CuculusBand/Light-Box/2_Release/Light-Box V1.00.00/Light-Box-B002/Light-Box-B002_PCB_V1.00.00.pdf

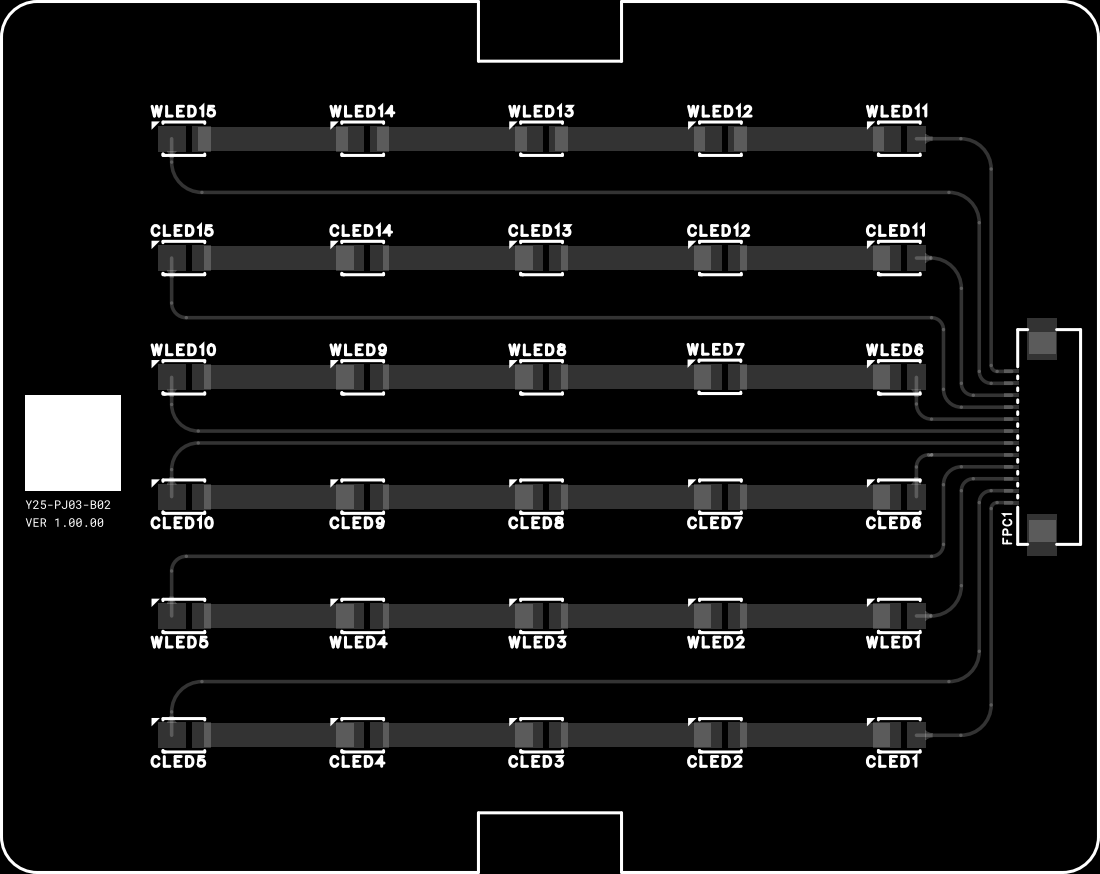
[picture p1: page 1]
