CuculusBand/Light-Box/1_Design_Documents/Appearance Sketch.png

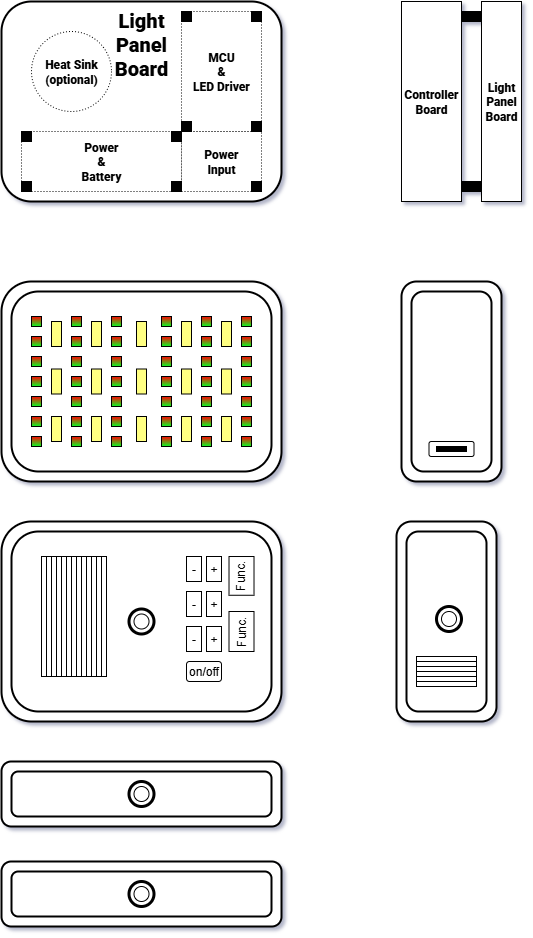
1_Design_Documents/Appearance Sketch.png
