CuculusBand/Light-Box/1_Design_Documents/Hardware Block Diagram.png

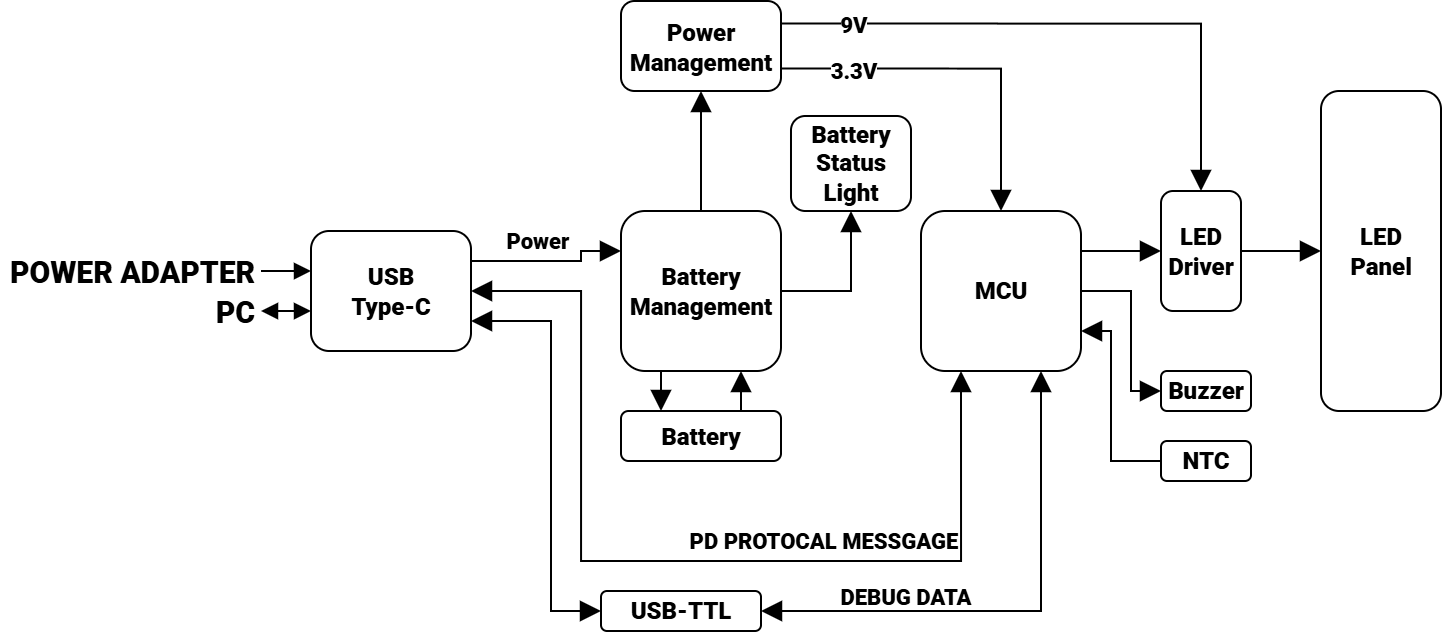
1_Design_Documents/Hardware Block Diagram.png
