CuculusBand/Light-Box/2_Release/Light-Box V1.00.00/Light-Box-B001/Light-Box-B001_BOM_V1.00.00.xlsx

Sheet: BOM
Bill of Materials | BOM_Light Box Main Board_Main Board_2025-09-27
Project Title： | Light Box
Variant:
Report Time： | 2025.9.27 13:52:49
No. | Quantity | Comment | Designator | Footprint | Value | Manufacturer Part | Manufacturer | Supplier Part | Supplier
1 | 3 | NCD0805G1 | BATLED1, BATLED2, LED2 | LED0805-R-RD |  | NCD0805G1 | 国星光电 | C84260 | LCSC
2 | 3 | NCD0805O1 | BATLED3, BATLED4, LED1 | LED0805-RD_ORANGE |  | NCD0805O1 | 国星光电 | C84262 | LCSC
3 | 1 | 2.4kHz | BUZZER1 | BUZ-TH_BD12.0-P7.60-D0.6-FD | 2.4kHz | TMB12A05 | 华能 | C96093 | LCSC
4 | 11 | 100nF | C1, C7, C12, C47, C48, C49, C50, C52, C53, C55, C56 | C0603 | 100nF | TCC0603X7R104K500CT | CCTC(三环) | C282519 | LCSC
5 | 1 | 10uF | C6 | C0603 | 10uF | CL10A106KP8NNNC | SAMSUNG(三星) | C19702 | LCSC
6 | 1 | 10uF | C16 | CAP-TH_BD4.0-P1.50-D0.8-FD | 10uF | KS106M050C07RR0VH2FP0 | CX(承兴) | C32856 | LCSC
7 | 1 | 22uF | C17 | CAP-TH_BD5.0-P2.00-D0.5-FD | 22uF | ERG50V22M5X11 | 捷而瑞 | C47344185 | LCSC
8 | 1 | 100nF | C18 | C1206 | 100nF | TCC1206M3L104J500FT | CCTC(三环) | C359189 | LCSC
9 | 4 | 4.7uF | C25, C26, C31, C32 | C0805 | 4.7uF | CGA0805X7R475K350MT | HRE(芯声) | C6119943 | LCSC
10 | 4 | 10uF | C27, C28, C29, C30 | C1206 | 10uF | CL31A106KBHNNNE | SAMSUNG(三星) | C13585 | LCSC
11 | 2 | 10uF | C37, C42 | C0805 | 10uF | 0805X106M250NT | FH(风华) | C669099 | LCSC
12 | 8 | 22uF | C38, C39, C40, C41, C43, C44, C45, C46 | C0805 | 22uF | CGA0805X5R226M250MT | HRE(芯声) | C6119899 | LCSC
13 | 3 | 1uF | C51, C54, C57 | C0603 | 1uF | CL10A105KB8NNNC | SAMSUNG(三星) | C15849 | LCSC
14 | 1 | B2B-XH-A(LF)(SN) | CN1 | CONN-TH_B2B-XH-A-LF-SN |  | B2B-XH-A(LF)(SN) | JST | C158012 | LCSC
15 | 2 | SS34 | D2, D3 | SMA_L4.3-W2.6-LS5.0-FD |  | SS34 | 宏迦橙 | C7420365 | LCSC
16 | 1 | SMAJ5.0A | D5 | SMA_L4.4-W2.6-LS5.0-RD |  | SMAJ5.0A | MDD(辰达半导体) | C113952 | LCSC
17 | 2 | PESD5V0L1BA | D6, D7 | SOD-323_L1.7-W1.3-LS2.5-BI |  | PESD5V0L1BA | TECH PUBLIC(台舟) | C2827691 | LCSC
18 | 1 | DS38W | D8 | SOD-123FL_L2.7-W1.8-LS3.8-RD |  | DS38W | 晶导微电子 | C437960 | LCSC
19 | 2 | LGS63032 | DRIVER1, DRIVER2 | SOT-23-6_L2.9-W1.6-P0.95-LS2.8-BR |  | LGS63032 | Legend-Si(棱晶半导体) | C5123977 | LCSC
20 | 1 | USBLC6-2SC6 | ESD1 | SOT-23-6_L2.9-W1.6-P0.95-LS2.8-BL |  | USBLC6-2SC6 | UMW(友台半导体) | C2687116 | LCSC
21 | 1 | AFA01-S12FCA-00 | FPC1 | FPC-SMD_12P-P1.00_FGS-XJ-H2.0 |  | AFA01-S12FCA-00 | JS(钜硕电子) | C262757 | LCSC
22 | 1 | GZ2012D601TF | L1 | L0805 |  | GZ2012D601TF | Sunlord(顺络) | C1017 | LCSC
23 | 2 | 22uH | L2, L3 | IND-SMD_L11.5-W10.0_FXL1040 | 22uH | FXL1040-220-M | cjiang(长江微电) | C475917 | LCSC
24 | 1 | 1uH | L5 | IND-SMD_L5.4-W5.2_FXL0530 | 1uH | FXL0530-1R0-M | cjiang(长江微电) | C475517 | LCSC
25 | 1 | 4.7uH | L6 | IND-SMD_L4.4-W4.2 | 4.7uH | FXL0420-4R7-M | cjiang(长江微电) | C167208 | LCSC
26 | 1 | 2N7002 | Q2 | SOT-23-3_L2.9-W1.3-P1.90-LS2.4-BR |  | 2N7002 | 宏迦橙 | C7420321 | LCSC
27 | 1 | S9013-E | Q3 | SOT-23-3_L2.9-W1.3-P1.90-LS2.4-BR |  | S9013-E | MDD(辰达半导体) | C41371419 | LCSC
28 | 2 | NC | R1, R2 | R0805 | NC
29 | 2 | MF52D 103F3950-100 | R3, R4 | RES-TH_BD3.0-P2.00-D0.3 |  | MF52D 103F3950-100 | 时恒 | C394024 | LCSC
30 | 2 | 4.7kΩ | R5, R8 | R0603 | 4.7kΩ | FRC0603F4701TS | FOJAN(富捷) | C2907034 | LCSC
31 | 2 | 510Ω | R6, R7 | R0805 | 510Ω | AECR0805F510RK9 | RESI(开步睿思) | C328402 | LCSC
32 | 11 | 10kΩ | R19, R21, R22, R24, R42, R47, R48, R49, R50, R51, R54 | R0805 | 10kΩ | 0805W8F1002T5E | UNI-ROYAL(厚声) | C17414 | LCSC
33 | 2 | 200kΩ | R20, R23 | R0805 | 200kΩ | FRC0805F2003TS | FOJAN(富捷) | C2907238 | LCSC
34 | 1 | 2Ω | R40 | R1206 | 2Ω | RC1206FR-072RL | YAGEO(国巨) | C137316 | LCSC
35 | 1 | 500mΩ | R41 | R0603 | 500mΩ | SCR0603JR500 | VO(翔胜) | C3017643 | LCSC
36 | 1 | 27kΩ | R43 | R0603 | 27kΩ | FRC0603F2702TS | FOJAN(富捷) | C2930084 | LCSC
37 | 1 | 1.8kΩ | R44 | R0603 | 1.8kΩ | 0603WAF1801T5E | UNI-ROYAL(厚声) | C4177 | LCSC
38 | 1 | 10kΩ | R45 | R0603 | 10kΩ | 0603WAF1002T5E | UNI-ROYAL(厚声) | C25804 | LCSC
39 | 1 | 1kΩ | R46 | R0805 | 1kΩ | ARG05BTC1001 | Viking(光颉) | C309081 | LCSC
40 | 1 | 100kΩ | R52 | R0603 | 100kΩ | 0603WAF1003T5E | UNI-ROYAL(厚声) | C25803 | LCSC
41 | 1 | 10Ω | R53 | R0603 | 10Ω | 0603WAF100JT5E | UNI-ROYAL(厚声) | C22859 | LCSC
42 | 1 | 51kΩ | R55 | R0805 | 51kΩ | 0805W8F5102T5E | UNI-ROYAL(厚声) | C17737 | LCSC
43 | 1 | 0Ω | R56 | R1206 | 0Ω | 1206W4F0000T5E | UNI-ROYAL(厚声) | C17888 | LCSC
44 | 2 | 1.1R | RSENSE1, RSENSE2 | R1210 | 1.1R | FRC1210F1R10TS | FOJAN(富捷) | C2933808 | LCSC
45 | 1 | EC11E15244G1 | SW1 | SW-TH_EC11E15244G1 |  | EC11E15244G1 | ALPSALPINE(阿尔卑斯阿尔派) | C370970 | LCSC
46 | 1 | PZ254V-11-04P | SWD1 | HDR-TH_4P-P2.54-V-M |  | PZ254V-11-04P | XFCN(兴飞) | C2691448 | LCSC
47 | 1 | K2-1107ST-A4DW-06 | SWRST | KEY-SMD_L6.2-W3.6-LS8.0 |  | K2-1107ST-A4DW-06 | 韩国韩荣 | C118141 | LCSC
48 | 2 | ZX-QC-ZC661626 | SW_Mode, SW_PWOWER | SW-TH_4P-L6.0-W6.0-P4.50-LS6.3 |  | ZX-QC-ZC661626 | Megastar(兆星) | C7419934 | LCSC
49 | 1 | STM32G071KBT6 | U1 | LQFP-32_L7.0-W7.0-P0.80-LS9.0-BL |  | STM32G071KBT6 | ST(意法半导体) | C529348 | LCSC
50 | 1 | AMS1117-3.3 | U3 | SOT-223-4_L6.5-W3.5-P2.30-LS7.0-BR |  | AMS1117-3.3 | UMW(友台半导体) | C347222 | LCSC
51 | 1 | IP5306 | U4 | ESOP-8_L4.9-W3.9-P1.27-LS6.0-BL-EP |  | IP5306 | INJOINIC(英集芯) | C181692 | LCSC
52 | 1 | CH340X | U6 | MSOP-10_L3.0-W3.0-P0.50-LS5.0-BL |  | CH340X | WCH(南京沁恒) | C3035748 | LCSC
53 | 1 | MFP6291LR-G1 | U8 | SOT-23-6_L2.9-W1.6-P0.95-LS2.8-BR |  | MFP6291LR-G1 | MSKSEMI(美森科) | C30197559 | LCSC
54 | 1 | TYPE-C 16P QTWT | USB1 | USB-TYPE-C-SMD_TYPE-C-16P-QTWT |  | TYPE-C 16P QTWT | SHOU HAN(首韩) | C5187472 | LCSC

Sheet: Field Summary
Project Title | Light Box
Borard Title | Light Box Main Board
Schematic Title
PCB Title | Main Board
Variant Name
Total Quantity | 109
Report Time | 13:52:49
Report Date | 2025.9.27
Report Date&Time | 2025.9.27 13:52:49
File Name | BOM_Light Box Main Board_Main Board_2025-09-27
Filter Option | Add into BOM:no;
