CuculusBand/Light-Box/2_Release/Light-Box V1.00.00/Light-Box-B002/Light-Box-B002_BOM_V1.00.00.xlsx

Sheet: BOM
Bill of Materials | BOM_Light Box CW LED Panel_CW Panel_2025-08-09
Project Title： | Light Box
Variant:
Report Time： | 2025.8.9 20:29:36
No. | Quantity | Comment | Designator | Footprint | Value | Manufacturer Part | Manufacturer | Supplier Part | Supplier
1 | 15 | HL-AM-2835H421W-S1-08-HR6 6500K | CLED1, CLED2, CLED3, CLED4, CLED5, CLED6, CLED7, CLED8, CLED9, CLED10, CLED11, CLED12, CLED13, CLED14, CLED15 | LED-SMD_L3.5-W2.8-FD-2835_WHITE |  | HL-AM-2835H421W-S1-08-HR6 6500K | HONGLITRONIC(鸿利光电) | C516135 | LCSC
2 | 1 | AFA01-S12FCA-00 | FPC1 | FPC-SMD_12P-P1.00_FGS-XJ-H2.0 |  | AFA01-S12FCA-00 | JS(钜硕电子) | C262757 | LCSC
3 | 15 | HL-AM-2835H421W-S1-08-HR6 3000K | WLED1, WLED2, WLED3, WLED4, WLED5, WLED6, WLED7, WLED8, WLED9, WLED10, WLED11, WLED12, WLED13, WLED14, WLED15 | LED-SMD_L3.5-W2.8-FD-2835_WHITE |  | HL-AM-2835H421W-S1-08-HR6 3000K | HONGLITRONIC(鸿利光电) | C516131 | LCSC

Sheet: Field Summary
Project Title | Light Box
Borard Title | Light Box CW LED Panel
Schematic Title
PCB Title | CW Panel
Variant Name
Total Quantity | 31
Report Time | 20:29:36
Report Date | 2025.8.9
Report Date&Time | 2025.8.9 20:29:36
File Name | BOM_Light Box CW LED Panel_CW Panel_2025-08-09
Filter Option | Add into BOM:no;
