CuculusBand/Light-Box/2_Release/Light-Box V1.00.00/Light-Box-B001/Light-Box-B001_SCH_V1.00.00.pdf

STM32G0 | POWER/RST/OSC

# Power Supply

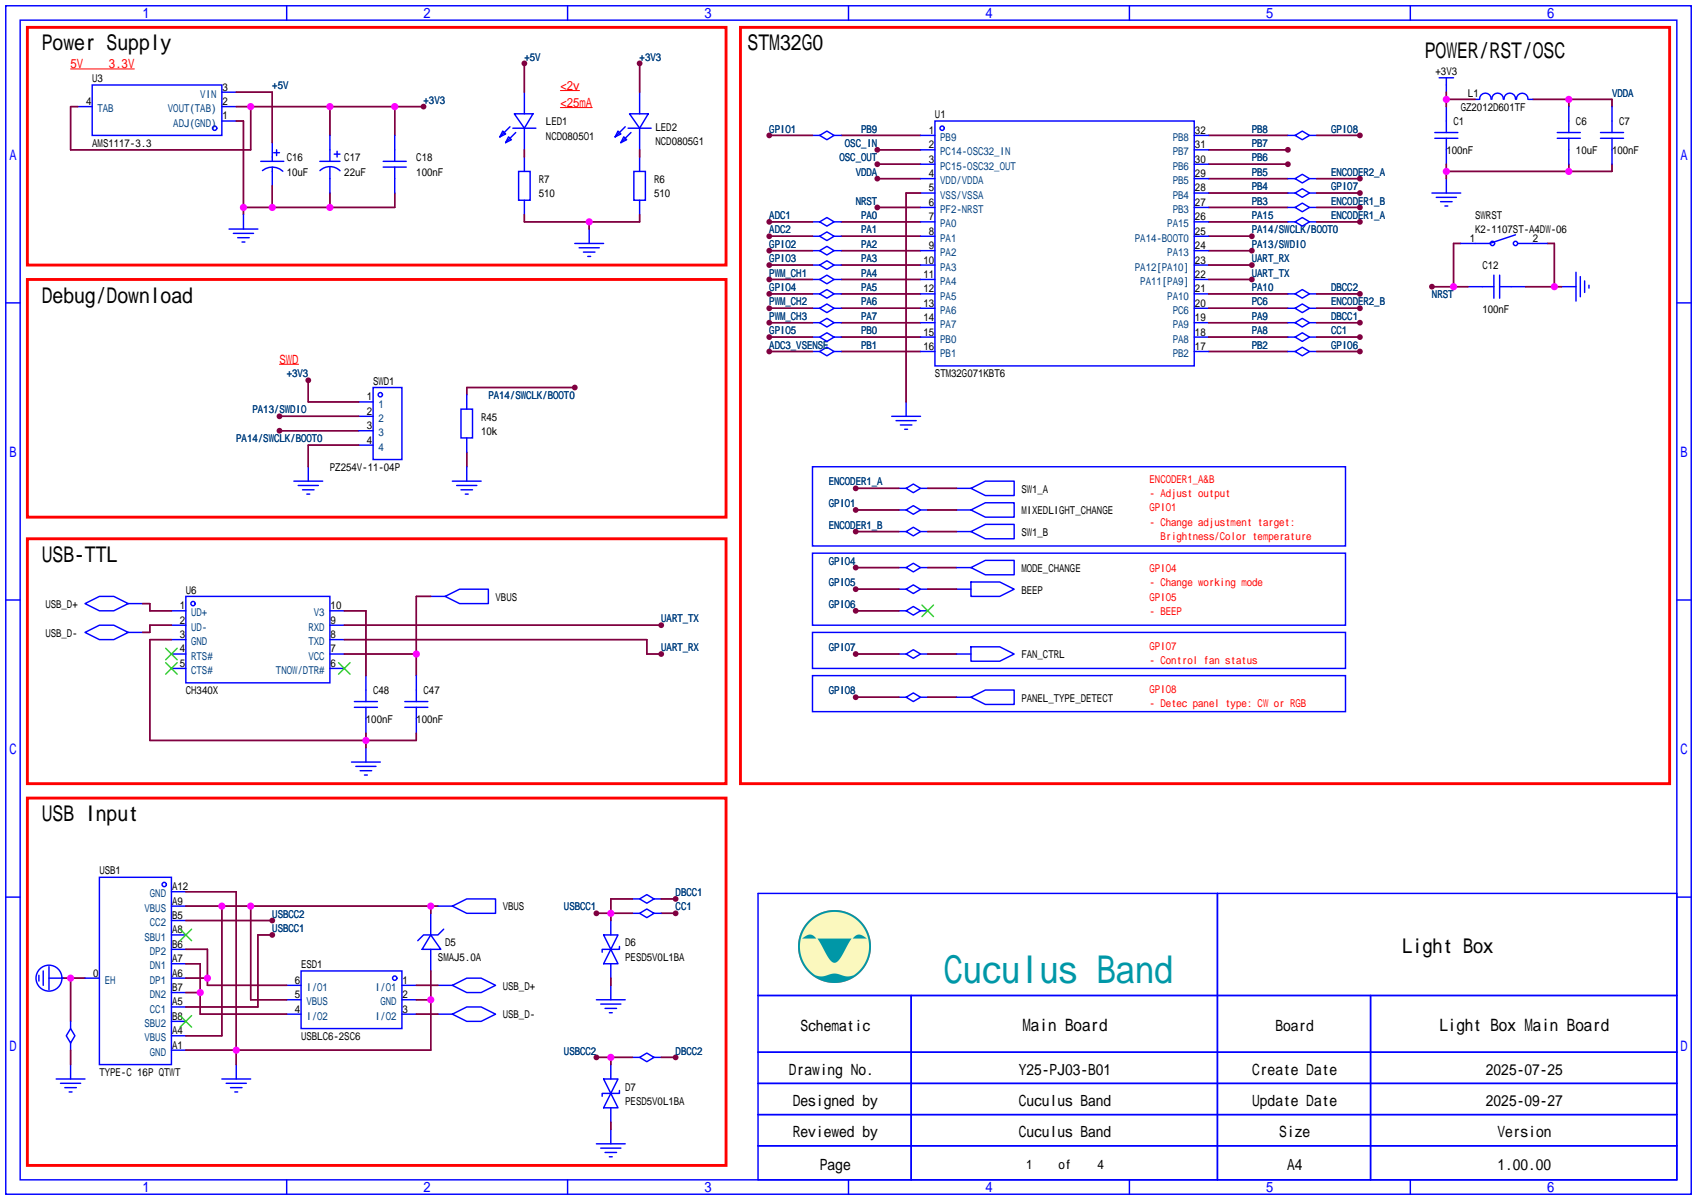
[picture p4: page 1]

GPIO8
- Detec panel type: CW or RGB

Cuculus Band | Light Box

Schematic | Main Board | Board | Light Box Main Board

Drawing No. | Y25-PJ03-B01 | Create Date | 2025-07-25

Designed by | Cuculus Band | Update Date | 2025-09-27

Reviewed by | Cuculus Band | Size | Version

Page | 1 of 4 | A4 | 1.00.00

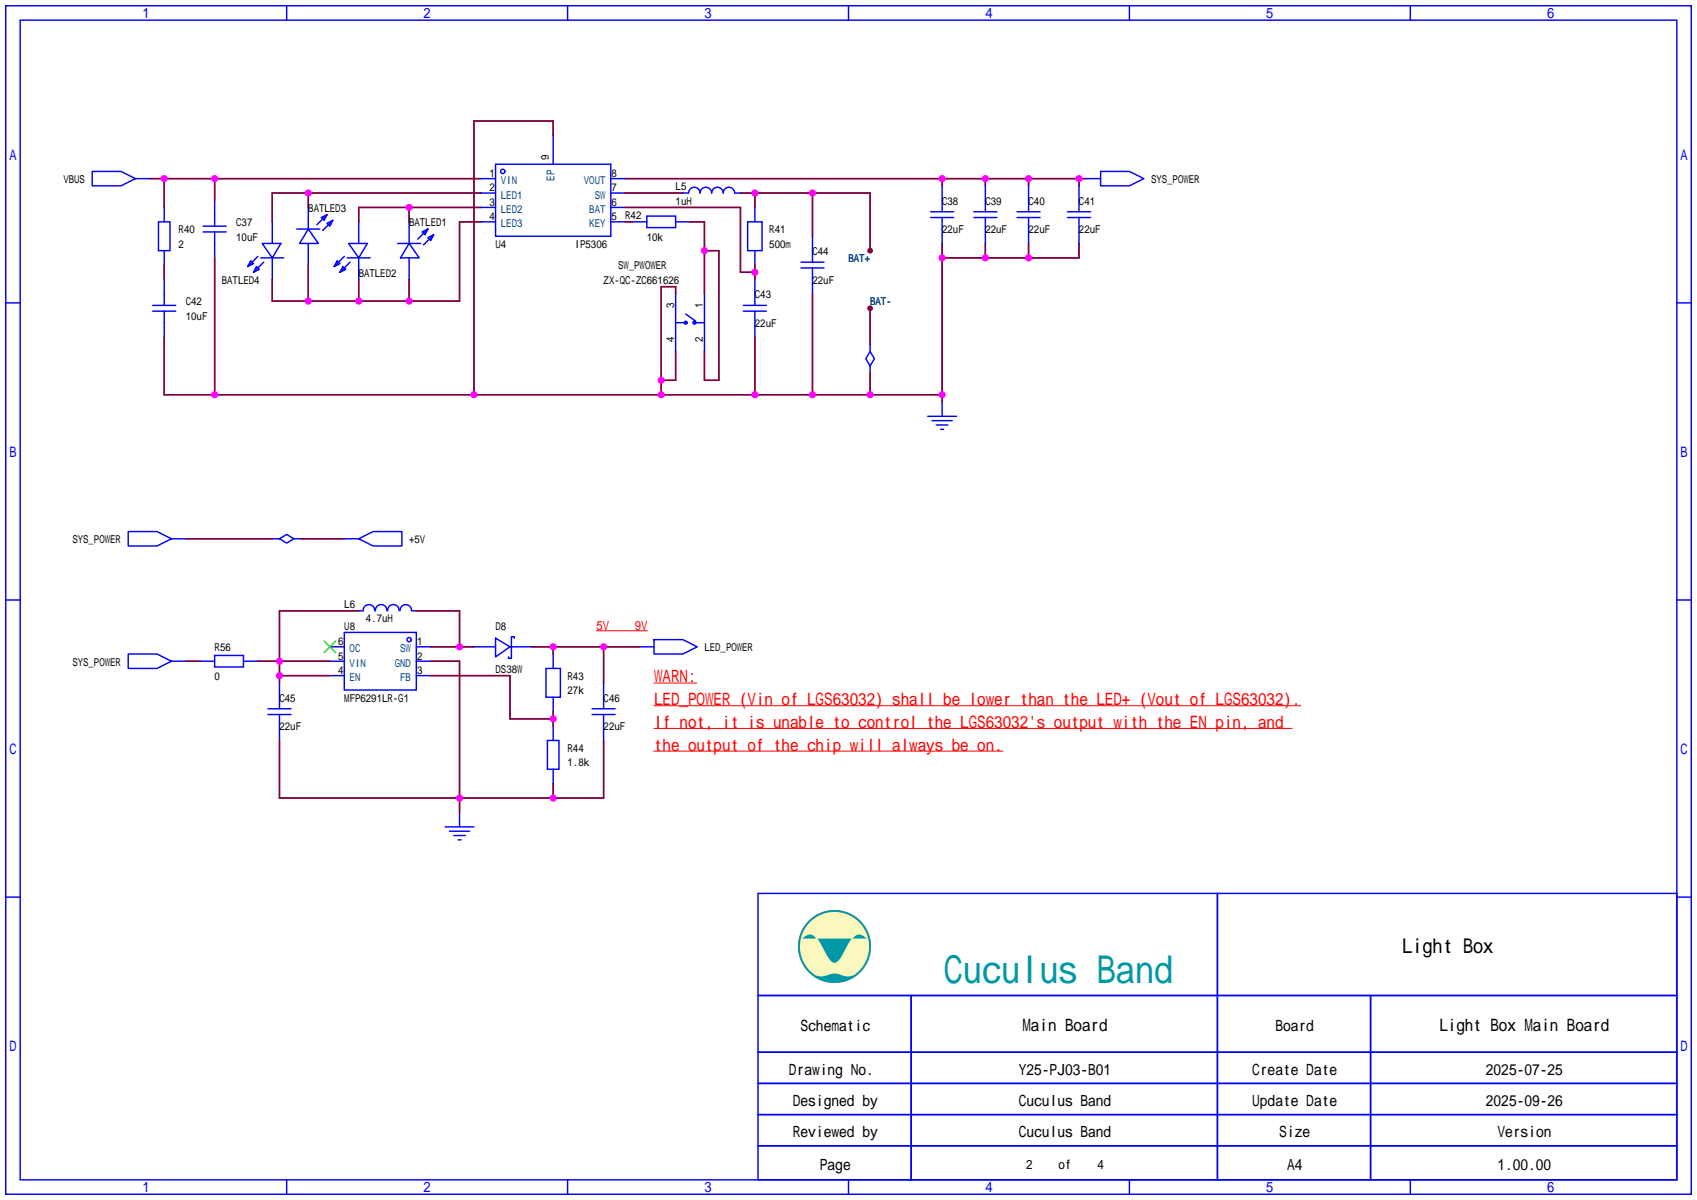
[picture p5: page 2]

LED_POWER (Vin of LGS63032) shall be lower than the LED+ (Vout of LGS63032).
If not, it is unable to control the LGS63032's output with the EN pin, and
the output of the chip will always be on.

Cuculus Band | Light Box

Schematic | Main Board | Board | Light Box Main Board

Drawing No. | Y25-PJ03-B01 | Create Date | 2025-07-25

Designed by | Cuculus Band | Update Date | 2025-09-26

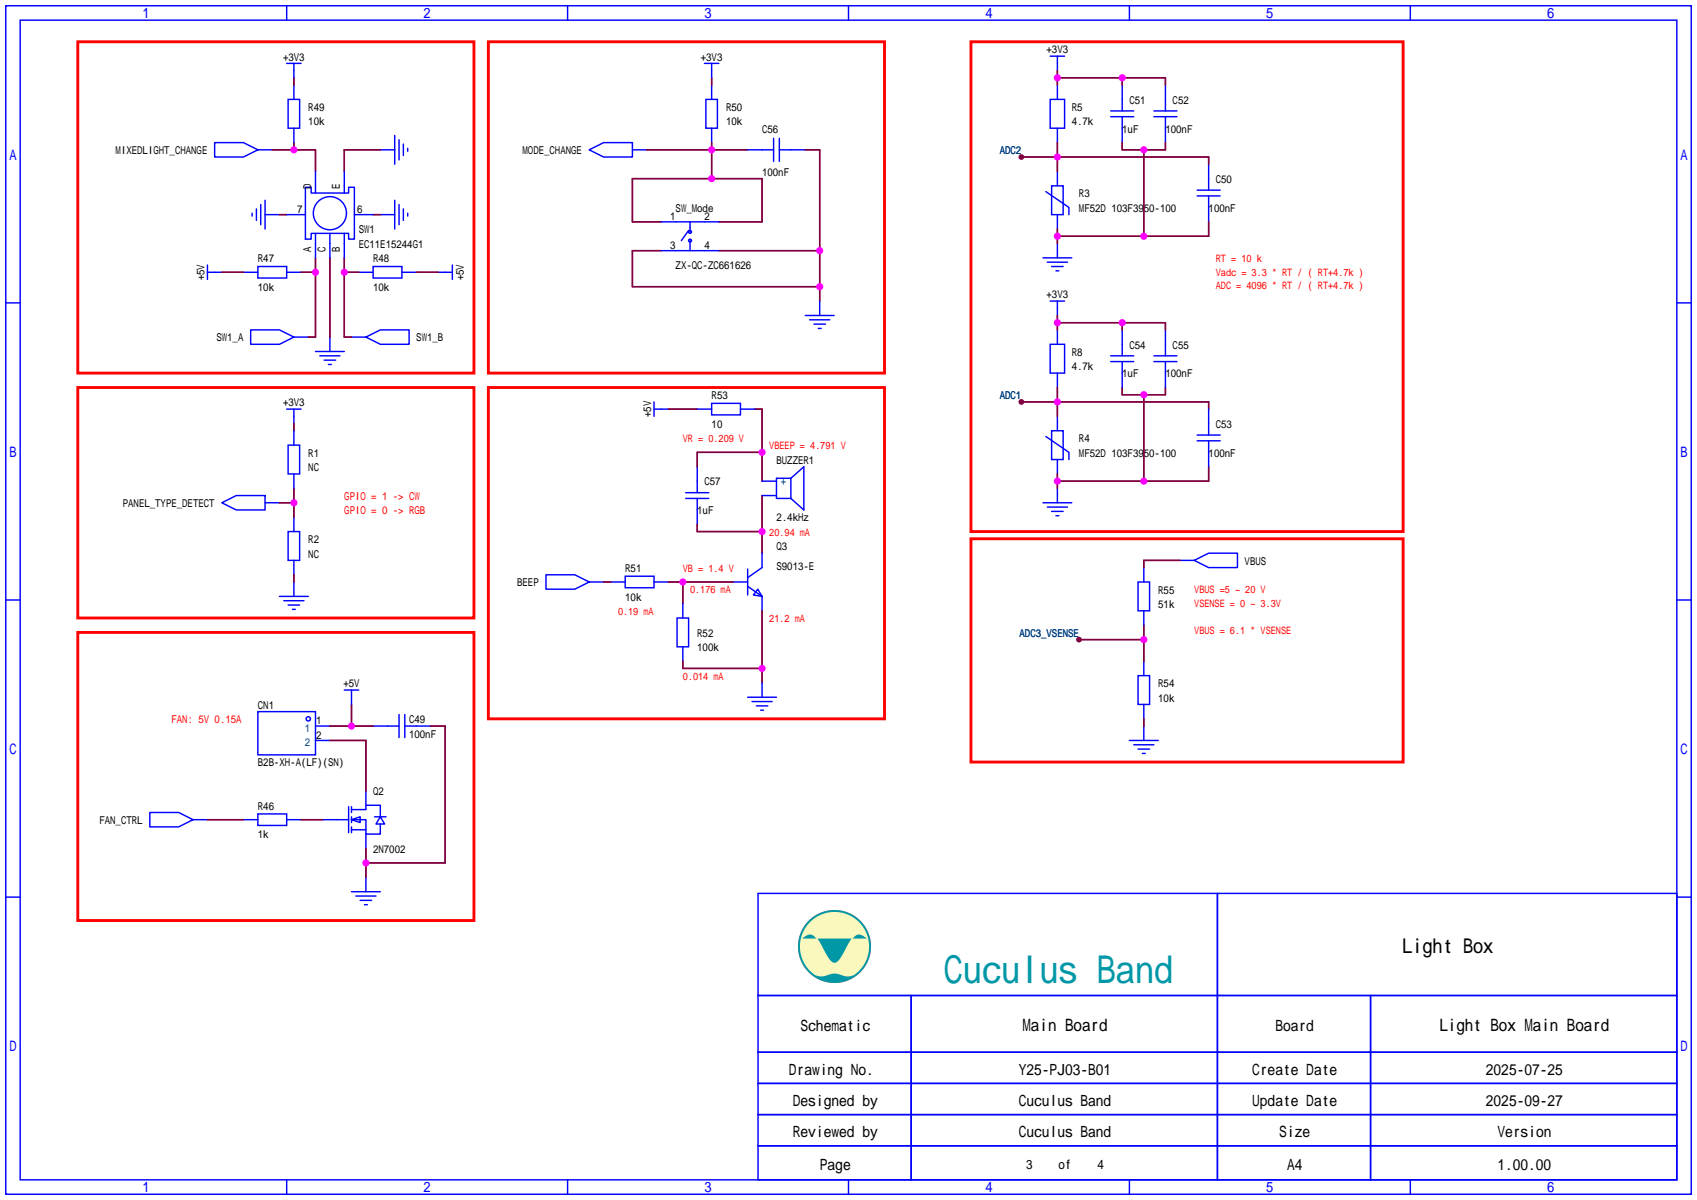
[picture p6: page 3]

Cuculus Band | Light Box

Schematic | Main Board | Board | Light Box Main Board

Drawing No. | Y25-PJ03-B01 | Create Date | 2025-07-25

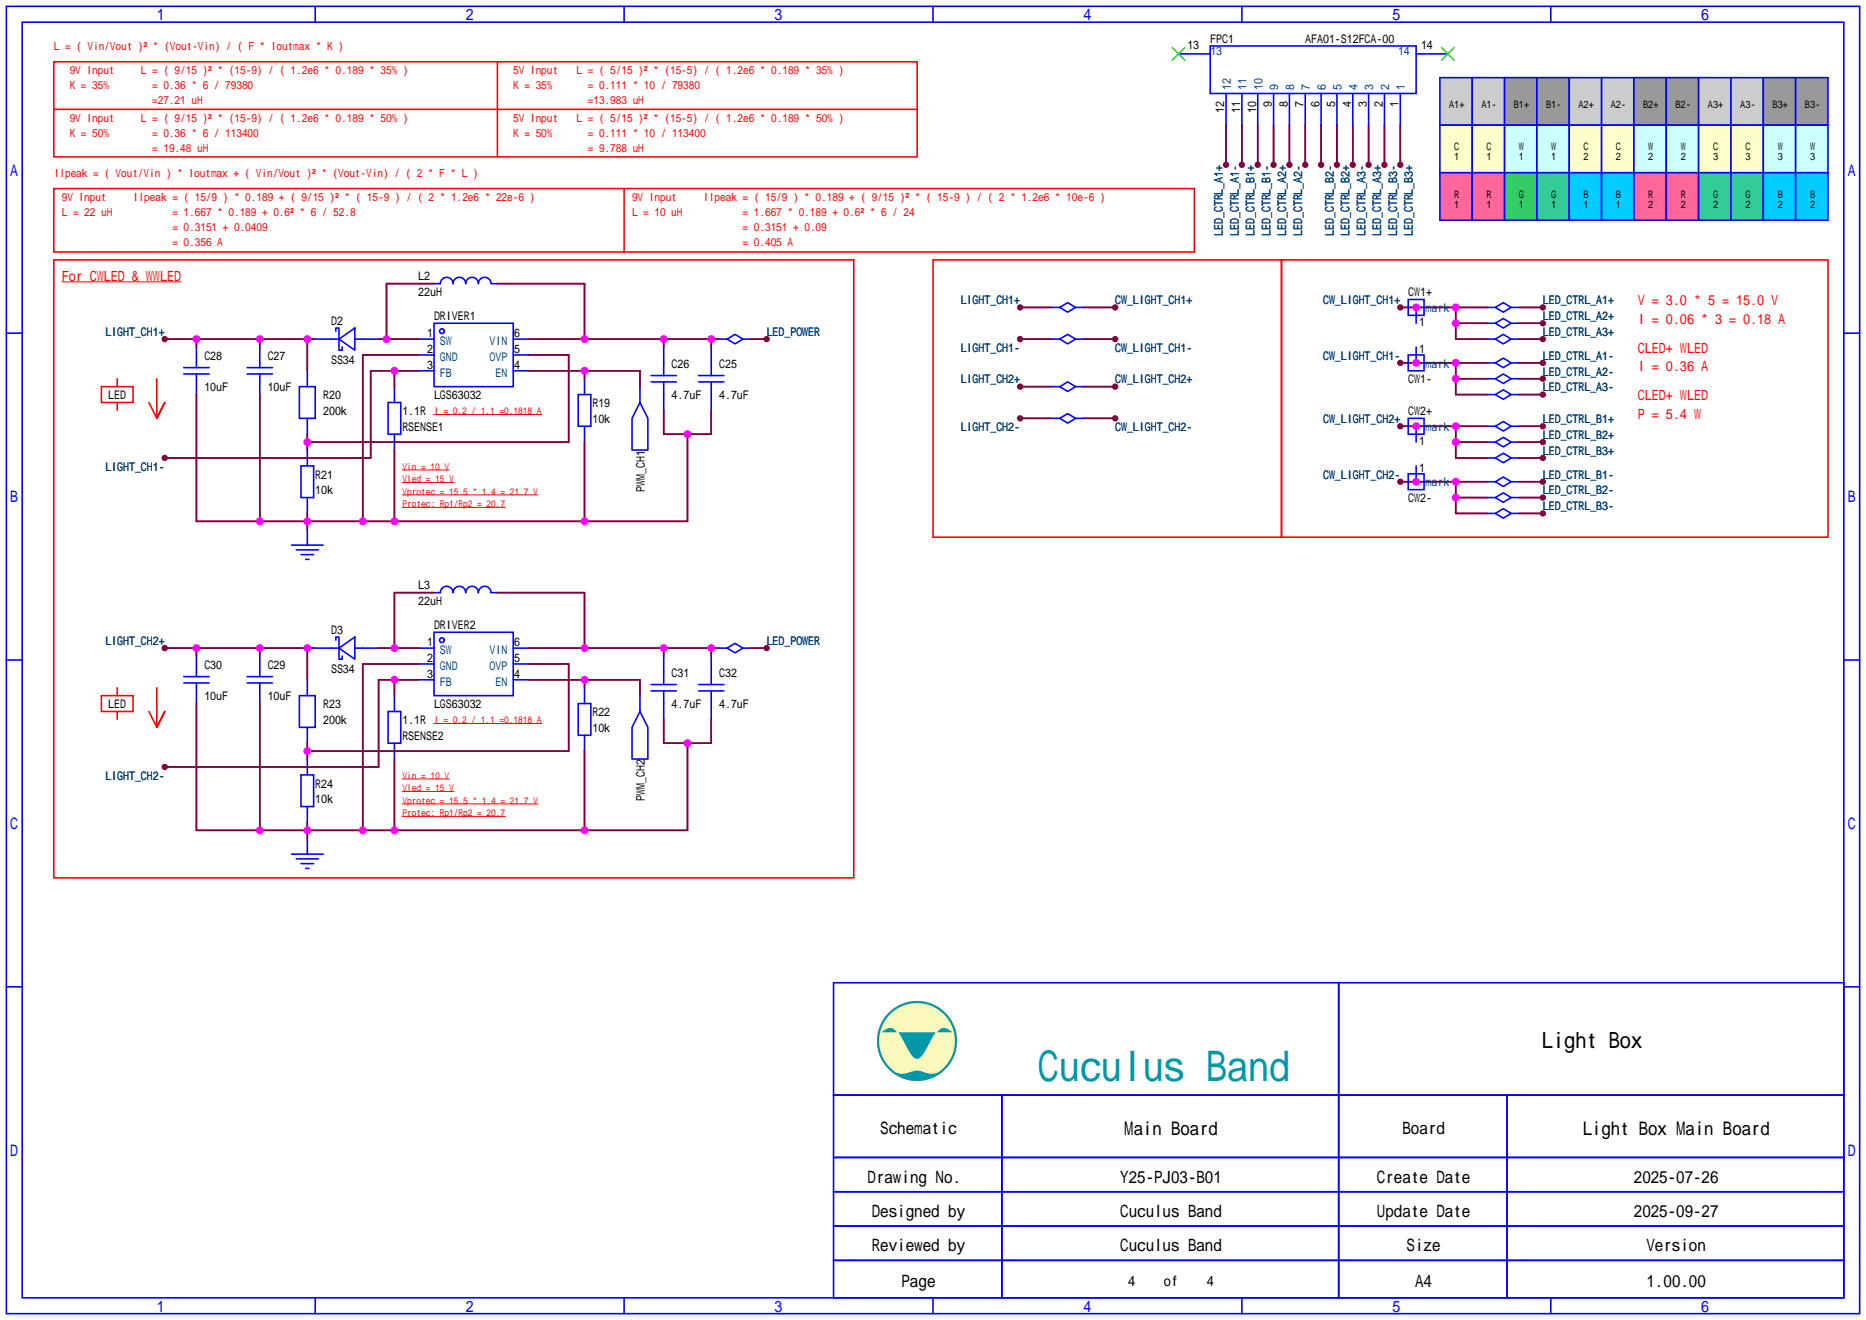
[picture p7: page 4]

L = ( Vin/Vout )² * (Vout-Vin) / ( F * Ioutmax * K )

Ilpeak = ( Vout/Vin ) * Ioutmax + ( Vin/Vout )² * (Vout-Vin) / ( 2 * F * L )

Cuculus Band | Light Box

Schematic | Main Board | Board | Light Box Main Board

Drawing No. | Y25-PJ03-B01 | Create Date | 2025-07-26
