CuculusBand/Light-Box/2_Release/Light-Box V1.00.00/Light-Box-B002/Light-Box-B002_SCH_V1.00.00.pdf

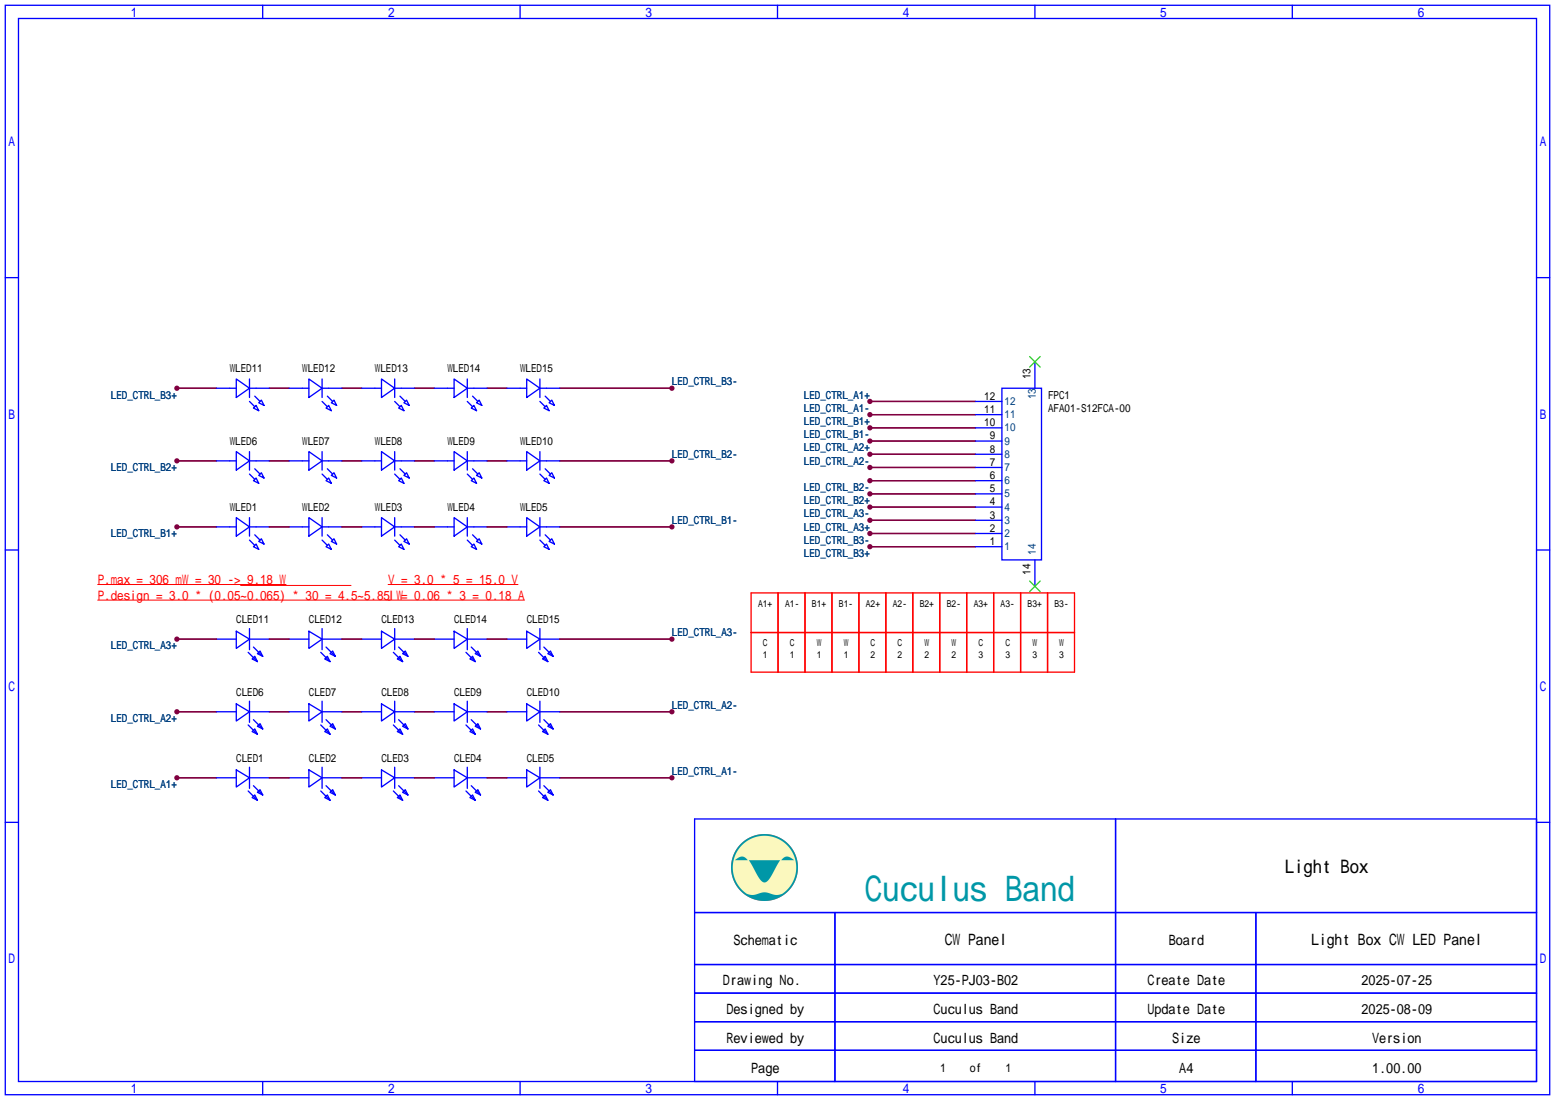
[picture p8: page 1]

Cuculus Band | Light Box

Schematic | CW Panel | Board | Light Box CW LED Panel

Drawing No. | Y25-PJ03-B02 | Create Date | 2025-07-25

Designed by | Cuculus Band | Update Date | 2025-08-09

Reviewed by | Cuculus Band | Size | Version

Page | 1 of 1 | A4 | 1.00.00
