CuculusBand/Light-Box/2_Release/Light-Box V1.00.00/Light-Box-B001/Light-Box-B001_PCB_V1.00.00.pdf

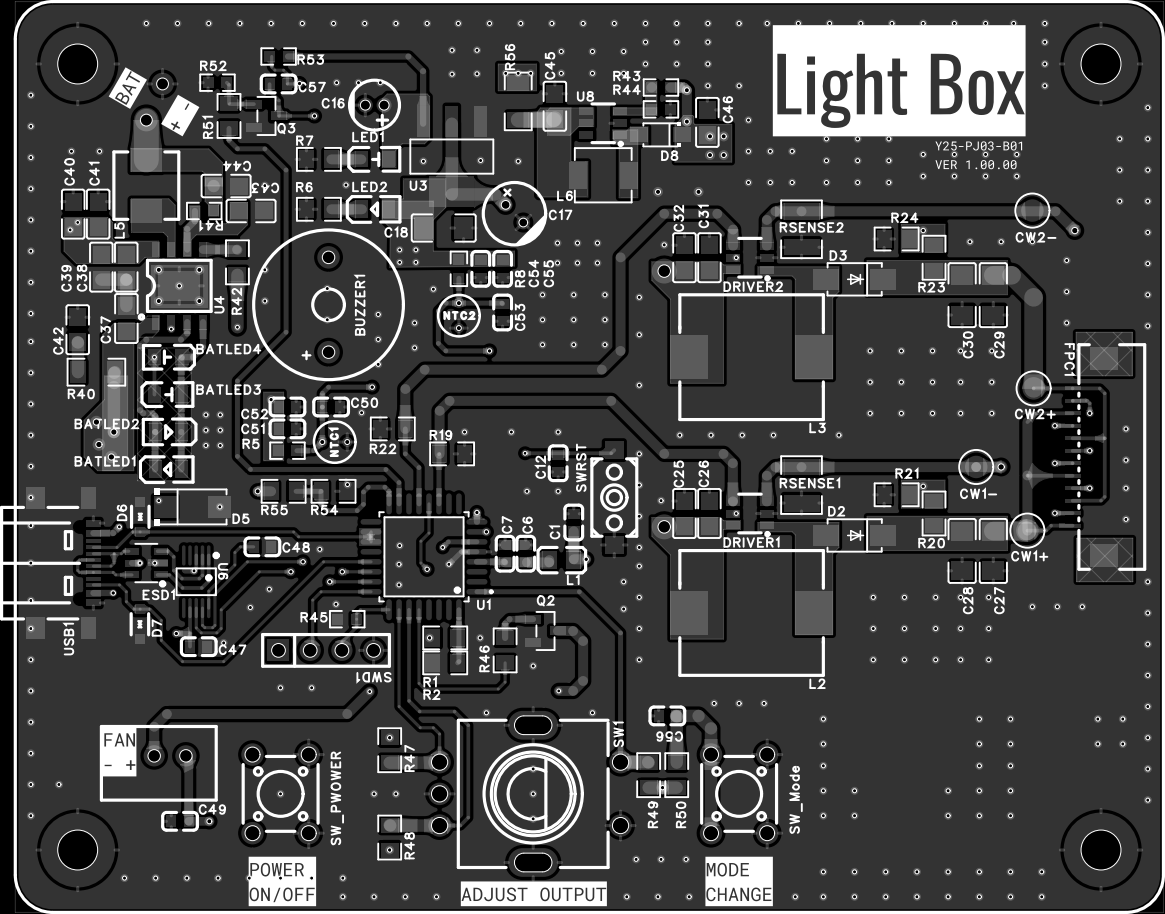
[picture p9: page 1]

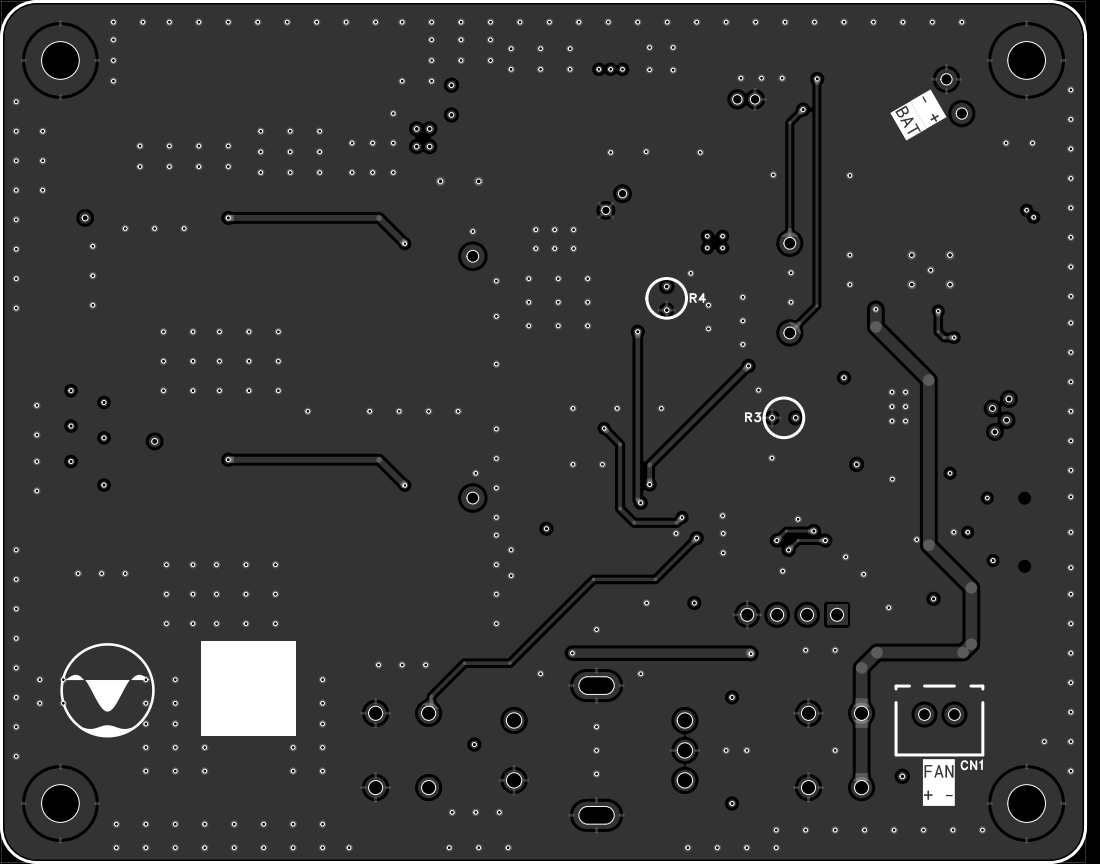
[picture p10: page 2]

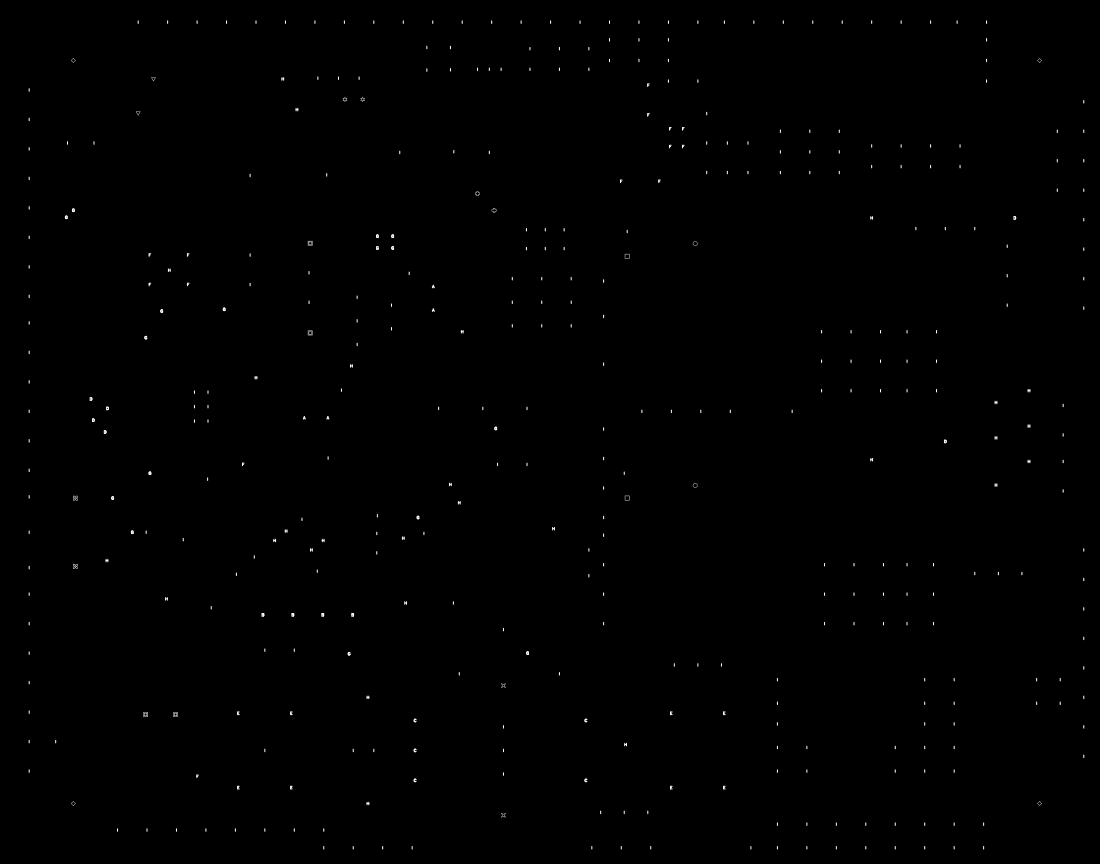
[picture p11: page 3]
