CuculusBand/Light-Box/0_Design_Source/Firmware/Light-Box/Core/Inc/main.h

#define OverTempLimit TempState
#define VDDA_APPLI 3300
#define Adjustment_Target_SW_Pin GPIO_PIN_9
#define Adjustment_Target_SW_GPIO_Port GPIOB
#define Temp_1_Pin GPIO_PIN_0
#define Temp_1_GPIO_Port GPIOA
#define Temp_2_Pin GPIO_PIN_1
#define Temp_2_GPIO_Port GPIOA
#define GPIO3_Pin GPIO_PIN_3
#define GPIO3_GPIO_Port GPIOA
#define PWM1_Pin GPIO_PIN_4
#define PWM1_GPIO_Port GPIOA
#define Mode_Change_SW_Pin GPIO_PIN_5
#define Mode_Change_SW_GPIO_Port GPIOA
#define PWM2_Pin GPIO_PIN_6
#define PWM2_GPIO_Port GPIOA
#define Beep_Ctrl_Pin GPIO_PIN_0
#define Beep_Ctrl_GPIO_Port GPIOB
#define VSENSE_Pin GPIO_PIN_1
#define VSENSE_GPIO_Port GPIOB
#define GPIO6_Pin GPIO_PIN_2
#define GPIO6_GPIO_Port GPIOB
#define USART_TX_Pin GPIO_PIN_9
#define USART_TX_GPIO_Port GPIOA
#define USART_RX_Pin GPIO_PIN_10
#define USART_RX_GPIO_Port GPIOA
#define ENCODER1_A_Pin GPIO_PIN_15
#define ENCODER1_A_GPIO_Port GPIOA
#define ENCODER1_B_Pin GPIO_PIN_3
#define ENCODER1_B_GPIO_Port GPIOB
#define Fan_Ctrl_Pin GPIO_PIN_4
#define Fan_Ctrl_GPIO_Port GPIOB
#define Panel_Type_Detec_Pin GPIO_PIN_8
#define Panel_Type_Detec_GPIO_Port GPIOB
#define current_chip_series "STM32G0xx" // Current chip series
#define factory 0  // 1: factory test mode; 0: normal mode
