CuculusBand/Light-Box/(commit log)

2025-08-16 Add STM32 firmware base (drivers + init) Includes: - STM32 HAL drivers from CubeMX - Peripheral setup (UART/GPIO/SPI)
2025-08-16 Add schematic files
2025-08-16 Add PCB 3D model
2025-08-16 Add PCB manufacturing files for version V1.00.00
    [Y25-PJ03-B001_BOM_V1.00.00.xlsx, Y25-PJ03-B002_BOM_V1.00.00.xlsx]
2025-08-16 Rename release files
    [Light-Box-B001_BOM_V1.00.00.xlsx, Light-Box-B002_BOM_V1.00.00.xlsx]
2025-08-17 Add timerbase setting
2025-08-17 Set the PWM channels‘ frequency to 100kHz
2025-08-18 Add function: Change the adjustment target of the encoder when a specific button is pressed and create the encoder queue for mode switching when initializing switch
2025-08-18 Add function: Adjust brightness and color temperature using encoder and update PWM output
2025-08-18 Update the summary of current functions in the APP layer
2025-08-19 Update firmware requirements Add NTC temperature measurement
2025-08-20 Add function Temperature measurement using NTX
2025-08-21 Test code generation and correct the code according to error information Variable name Function return value type Header file ADC sampling period for temperature measurement Disable GUI initializatio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
    [beep.c, mixedlight_switch.c, mixedlight_switch.h, ntc_temperature.c, ntc_temperature.h, pwm_app.c]
2025-08-24 Add function Shortcut for cut-off and start output
    [shortcut.c, shortcut.h]
2025-08-30 Avoid using Beep_Nonblocking before RTOS initialized
    [main.c]
2025-08-30 Add an alternative material for DS38W
    [Light-Box-B001_BOM_V1.00.00.xlsx]
2025-08-31 Disable "save power of non-active UCPD"
2025-08-31 Fix the error name of the ADC channel
    [Light-Box.ioc, main.h]
2025-09-04 Move Encoder and PWM initialization into the FreeRTOS task
2025-09-04 Add format conversion functions used for converting float numbers to strings to print them by sprintf()
2025-09-04 Implement the temperature detection function in StartDefaultTask(); ADC logic ought to be optimized
2025-09-05 Fixed the incorrect judgment condition in temperature calculation
    [ntc_temperature.c]
2025-09-05 Enable DMA of ADC
2025-09-05 Implement ADC data transfer via DMA
2025-09-06 Change ADC sampling cytime and add VBUS monitor in FreeRTOS task
2025-09-06 Rewrite the temperature monitoring task, and the interval of data collection is controlled by app_freertos.c
2025-09-06 Implement the function of limiting brightness based on temperature
2025-09-06 Fix the wrong message
    [main.c]
2025-09-06 Rewrite the temperature status check function to support any number of NTCs
2025-09-07 Update Beep_NonBlocking to prevent creating multiple timers on repeated calls
    [beep.c, beep.h]
2025-09-07 Code cleanup and provide a api to get current mode
2025-09-08 Add PWM stop function
2025-09-08 Complete tasks in app_freertos.c, but the shortcut function needs to be optimized
    [app_freertos.c, shortcut.c]
2025-09-09 Staging shortcut function optimization
    [app_freertos.c, shortcut.c, shortcut.h]
2025-09-12 Optimize the data format conversion function, fix the precision bug in the old version
    [data_format.c]
2025-09-12 Change to use nosys.specs to avoid using float2ascii before sending float data through UART
    [app_freertos.c]
2025-09-12 Change the precision of temperature data
2025-09-14 Add debug info and fix variable adjustment rate
    [encoder.c, encoder.h]
2025-09-14 Rename function and adjust temperature limits
2025-09-14 Rewrite the shortcut key control logic and use the lock flag to control the encoder status
    [app_freertos.c, encoder.c, encoder.h]
2025-09-14 Optimize temperature protection logic to update the PWM output when the temperature status changes
2025-09-14 Rename temperature monitor function files and move them into the APP folder
2025-09-14 Revert "Changed msg from static global to local stack variable to reduce RAM usage"
    This reverts commit 9cb11daae63b6f16acfb5e43368e3e325754c076.
    [app_freertos.c, encoder.c, pwm_app.c, temperature_monitor.c]
2025-09-14 Fix the debug info sending funciton
    [temperature_monitor.c]
2025-09-14 Shorten the interval of Encoder_Update()
    [app_freertos.c]
2025-09-14 Start PWM output after initialization
2025-09-14 Set brightness to 0 during encoder initialization
2025-09-14 Adjust temperature limit
2025-09-22 Add PWM start function
2025-09-22 Change the function of PWM_App_Init to set the CCR of PWM timer to 0
2025-09-22 Start PWM output after initialize TIMs' CCR
2025-09-22 Add debug info, return crr in timers
2025-09-22 Optimize ram usage, avoid complex calculations
    [encoder.c]
2025-09-22 Reset PWM frequency to 8kHz
    [Light-Box.ioc]
2025-09-22 Set PWM frequency to 2kHz
2025-09-22 Adjust encoder step
2025-09-22 Set PWM frequency to 1.6kHz
2025-09-22 Try to fix the wrong PWM output when powering up
    [app_freertos.c, pwm_app.c]
2025-09-22 Reset GPIO of PWM
    [main.c]
2025-09-23 Change PWM frequency and disable TIM17 which is unused
2025-09-23 Set PWM GPIO default state to pull-down
2025-09-23 Try to fix the incorrect lighting at boot up
    [Light-Box.ioc, app_freertos.c, main.c]
2025-09-23 Disable TIM3 and enable pull-down of the encoder's GPIO
2025-09-23 Set GPIO of PWM to push-pull mode and pull-down before initiation of timers
2025-09-26 Minor fixes: 1. Disconnect DTR and RTS of CH340X from STM32 to avoid the error state of BOOT and NRST when connecting the board to the PC with UART 2. Change pull-down resistance of BOOT0 to 10kΩ 3. 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
2025-09-26 Troubleshooting Unexpected Output from the LGS63032, and update comments in the schematics Conclusion: The uncontrolled output of the LGS63032 is caused by poor soldering of the FB pin of the precedi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
2025-09-27 Optimize PCB layouts
2025-09-27 Update release files
    [Light-Box-B001_BOM_V1.00.00.xlsx, Light-Box-B002_BOM_V1.00.00.xlsx]
2025-09-27 Update 3D models of PCBs
2025-09-27 Refine beep behavior for improved interaction: 1. Distinguish system boot beep and PD activation beep 2. Add beep feedback when the encoder reaches max/min brightness or color temperature
2025-09-27 Update notes in schematics
