CuculusBand/Light-Box/(notices)

Notices in the files:
0_Design_Source/Firmware/Light-Box/Core/Src/app_freertos.c:
Copyright (c) 2025 STMicroelectronics.
All rights reserved.
This software is licensed under terms that can be found in the LICENSE file
